Diwamoto/ownly/README.md

# ownly

ownly is 58 key qwerty custom split keyboard

[buildguide](https://github.com/Diwamoto/ownly/blob/master/docs/buildguide.md "buildguide")

This product released under the GNU GPL.
画像1

画像2

画像3

画像4
