Diwamoto/ownly/docs/stabilizer.md

# スタビライザの組み立て方
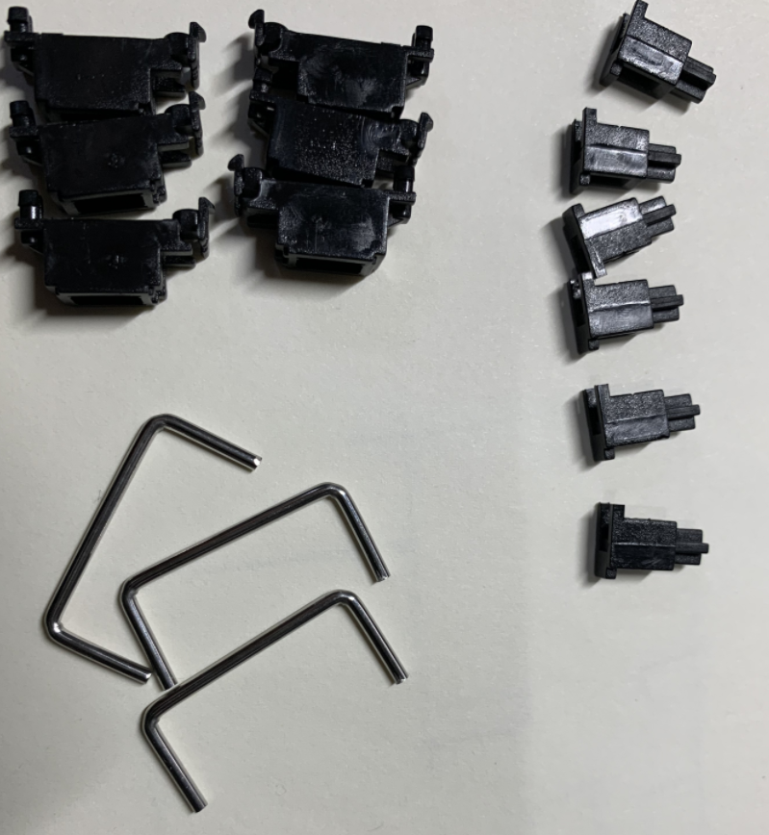
[picture p1: img/全体.png]


スタビライザは下記の三つの部品からなります（画像は3セット分）
・ワイヤ
・ハウジング
・ステム

## 1 向きを確認する
スタビライザのハウジングとステムには向きがあります。

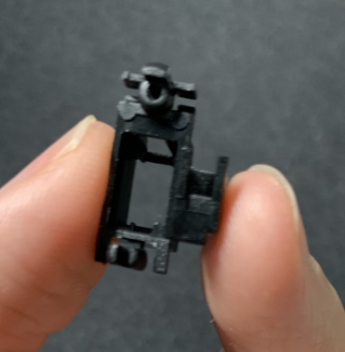
[picture p2: img/向き.png]


画像の向きに合わせて、差し込みます。

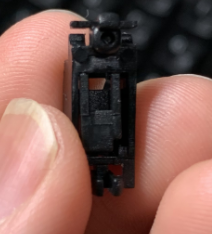
[picture p3: img/位置.png]


## 2 金具をひっかけます。
金具をハウジングにひっかけます。

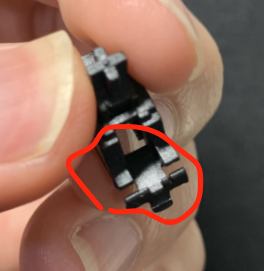
[picture p4: img/方向.png]


ひっかける方向は画像の赤くなっている部分です。
画像のように差し込んで、

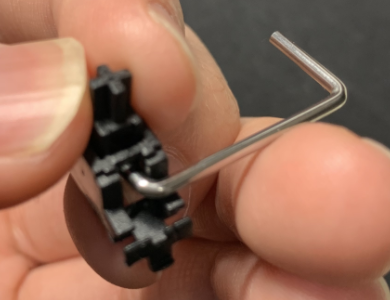
[picture p5: img/差し込む.png]


ひっかけます

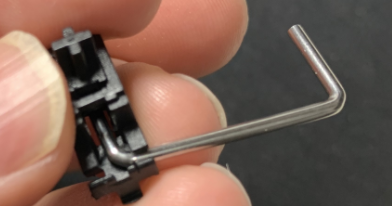
[picture p6: img/ひっかける.png]


反対側も同じようにして完成です。

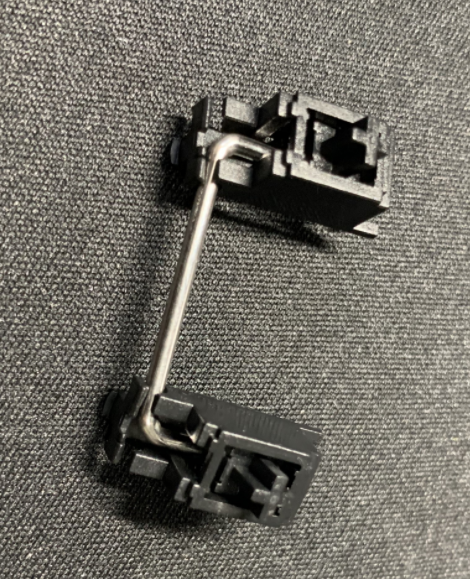
[picture p7: img/完成図.png]
