Diwamoto/ownly/img/IMG_6416.JPG

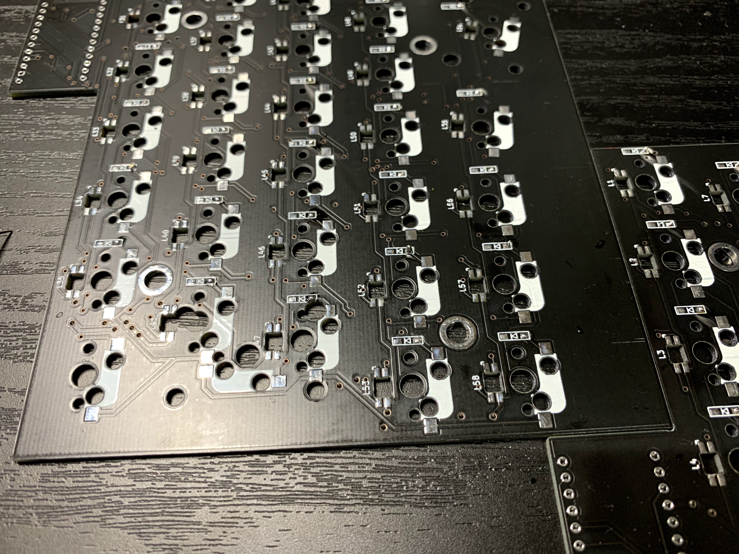
img/IMG_6416.JPG
