Diwamoto/ownly/img/IMG_6417.JPG

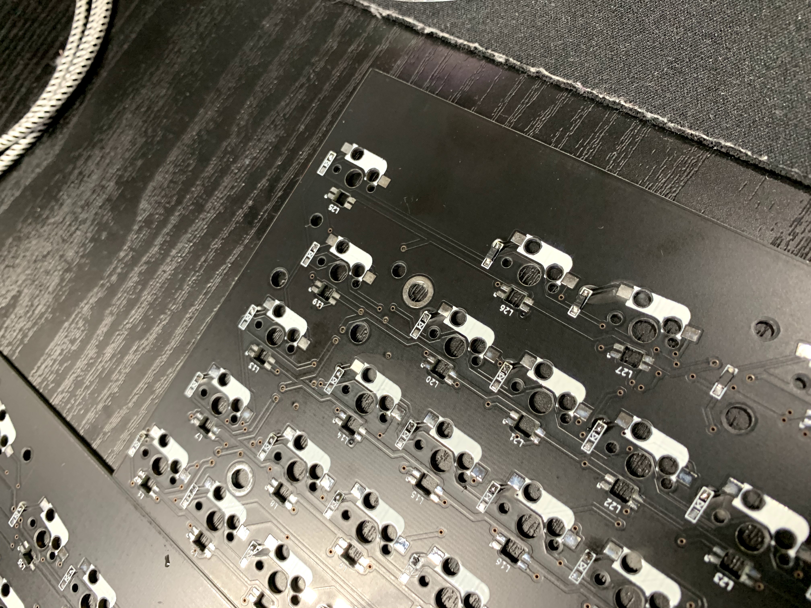
img/IMG_6417.JPG
