Diwamoto/ownly/img/IMG_6419.JPG

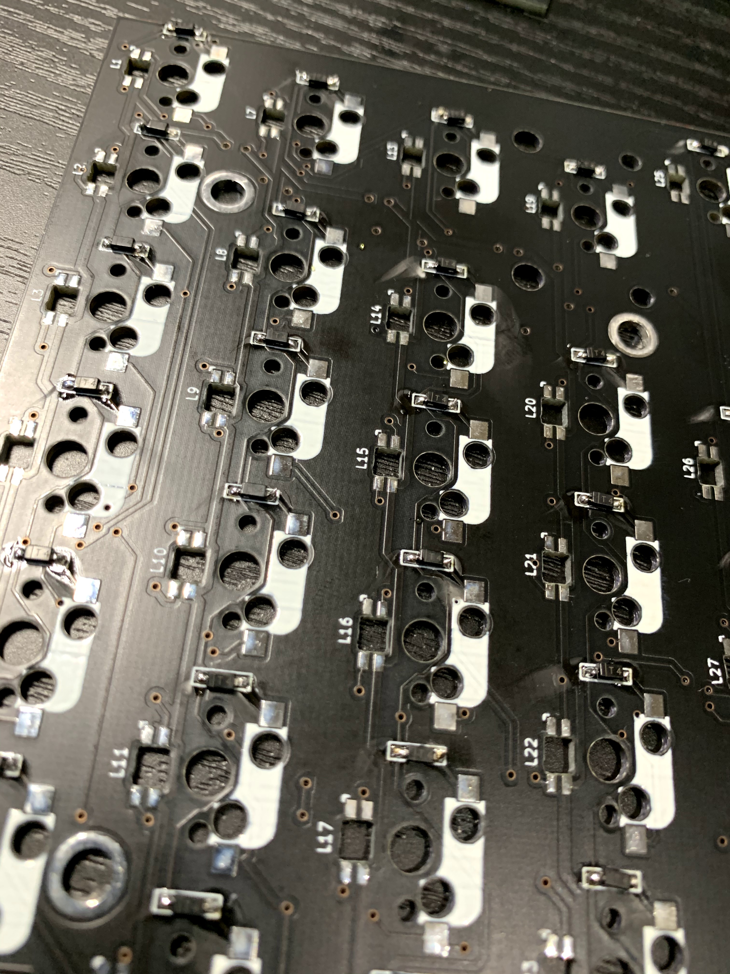
img/IMG_6419.JPG
