Diwamoto/ownly/img/IMG_6426.JPG

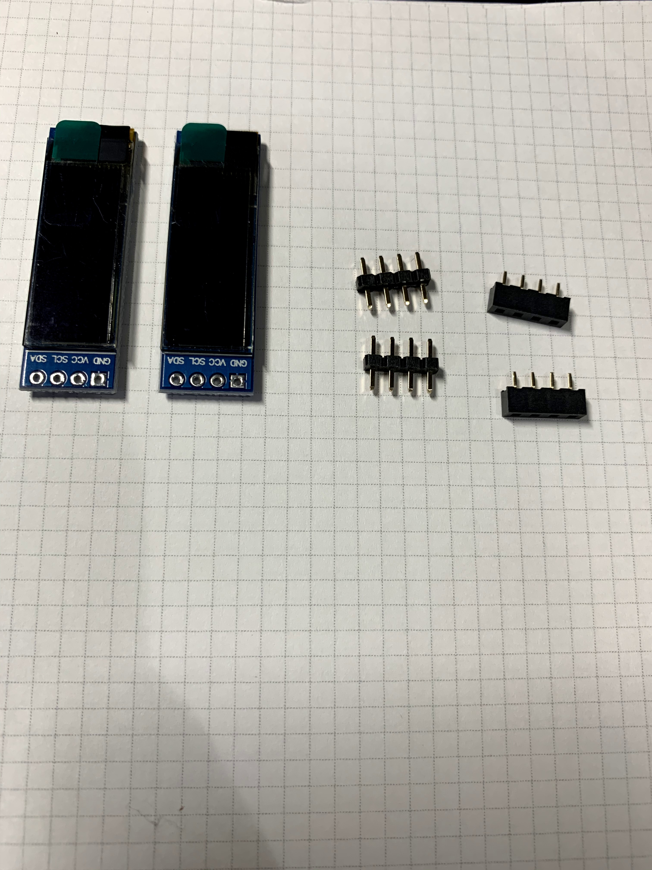
img/IMG_6426.JPG
