Diwamoto/ownly/img/IMG_6427.JPG

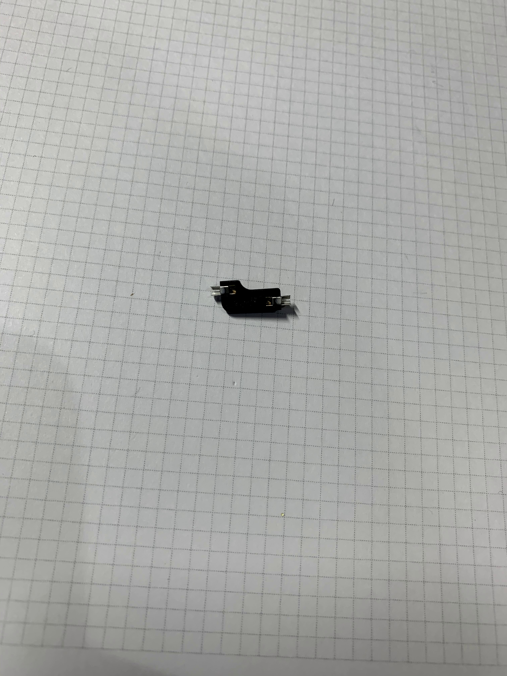
img/IMG_6427.JPG
