Diwamoto/ownly/img/IMG_6428.JPG

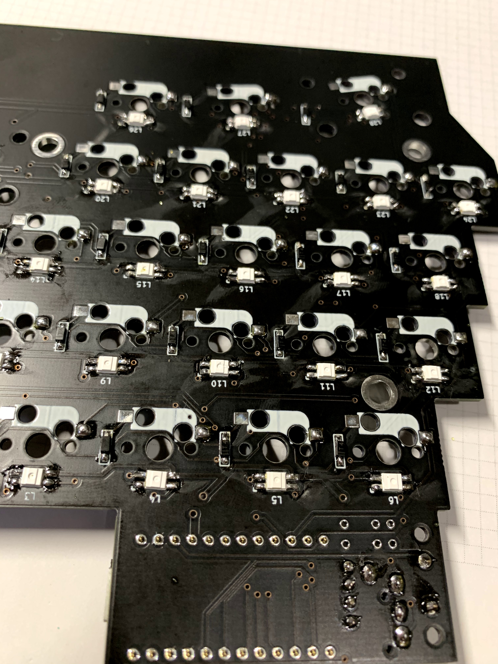
img/IMG_6428.JPG
