Diwamoto/ownly/img/IMG_6429.JPG

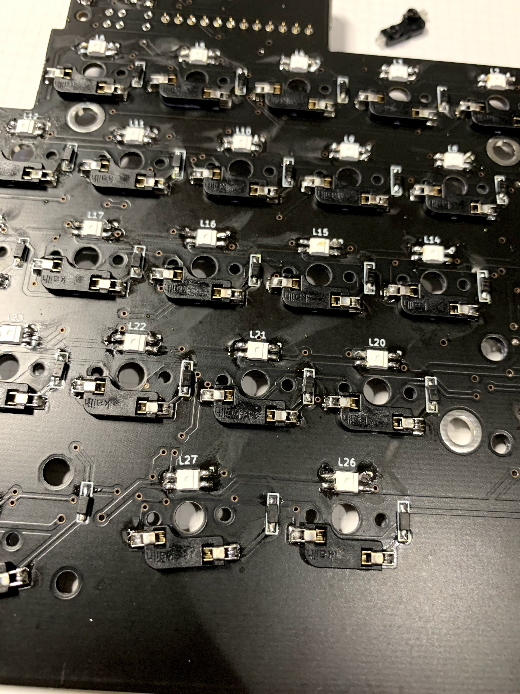
img/IMG_6429.JPG
