Diwamoto/ownly/img/oled.png

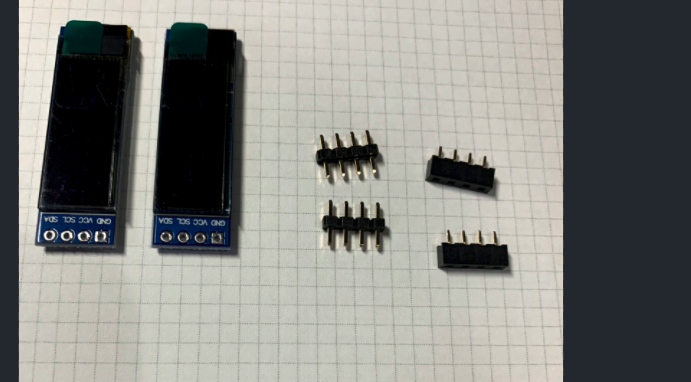
img/oled.png
