Diwamoto/ownly/img/スイッチ取り付け.png

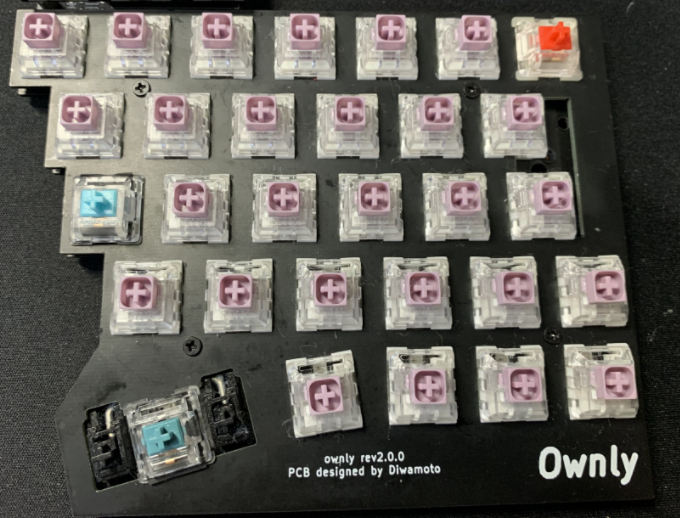
img/スイッチ取り付け.png
