Diwamoto/ownly/img/追加プレート取り付け.png

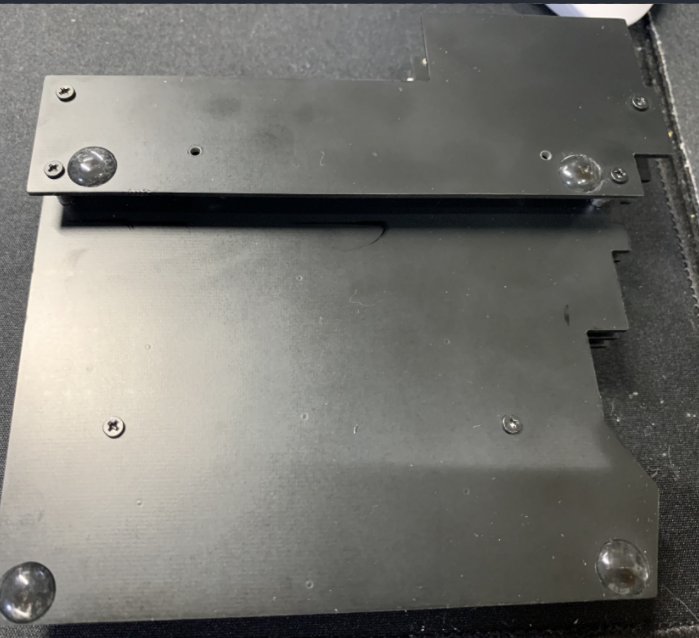
img/追加プレート取り付け.png
