Diwamoto/ownly/dxf/ownly-top-plate-Edge_Cuts.dxf

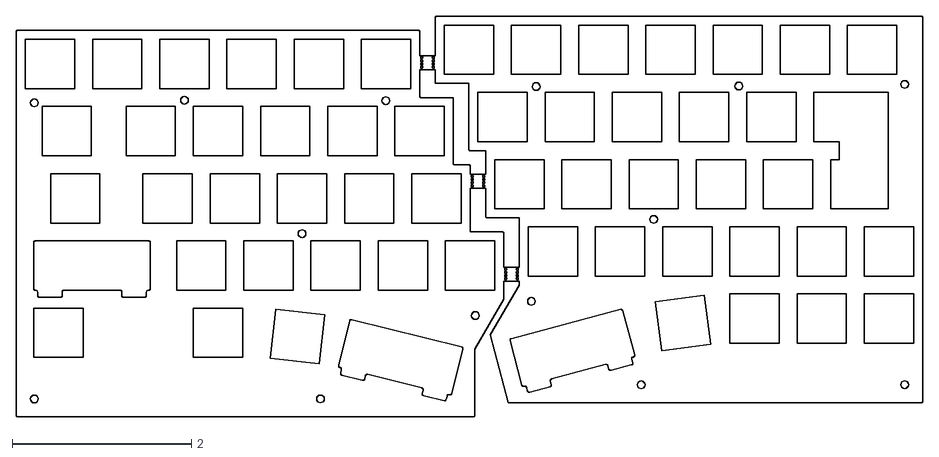
[picture p24: CAD file, 2021-02-08]
dxf/ownly-top-plate-Edge_Cuts.dxf
10.1 x 4.47
