Diwamoto/ownly/dxf/ownly-Edge_Cuts.dxf

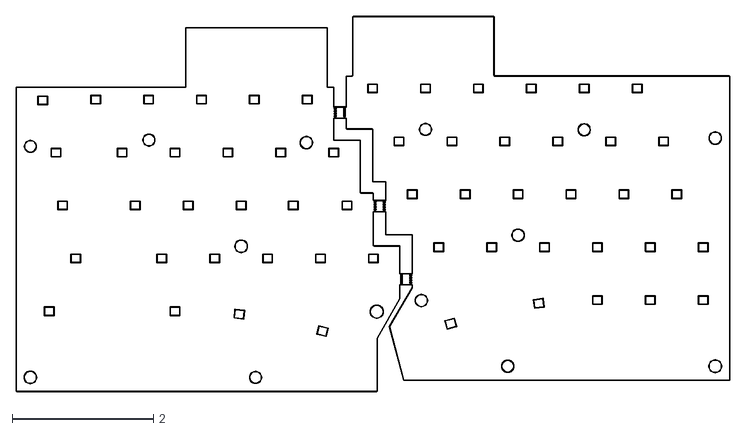
[picture p25: CAD file, 2020-08-29]
dxf/ownly-Edge_Cuts.dxf
10.1 x 5.32
