Diwamoto/ownly/PCB/ownly.pdf

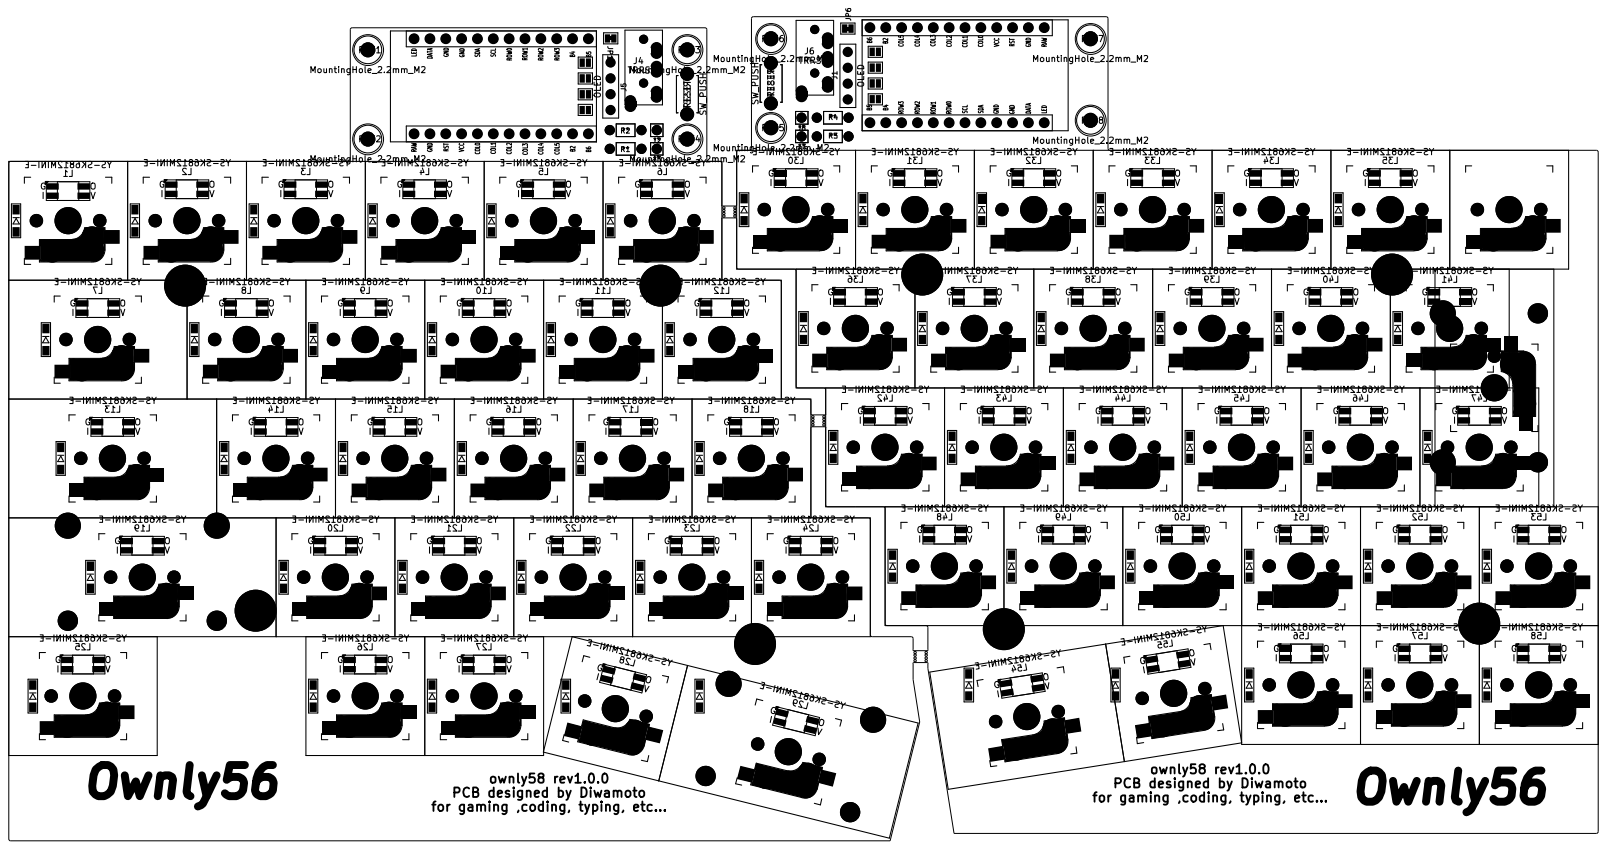
[picture p46: page 1]
