Diwamoto/ownly/PCB/ownly.kicad_pcb

## KiCad design PCB/ownly.kicad_pcb (2020-10-05)

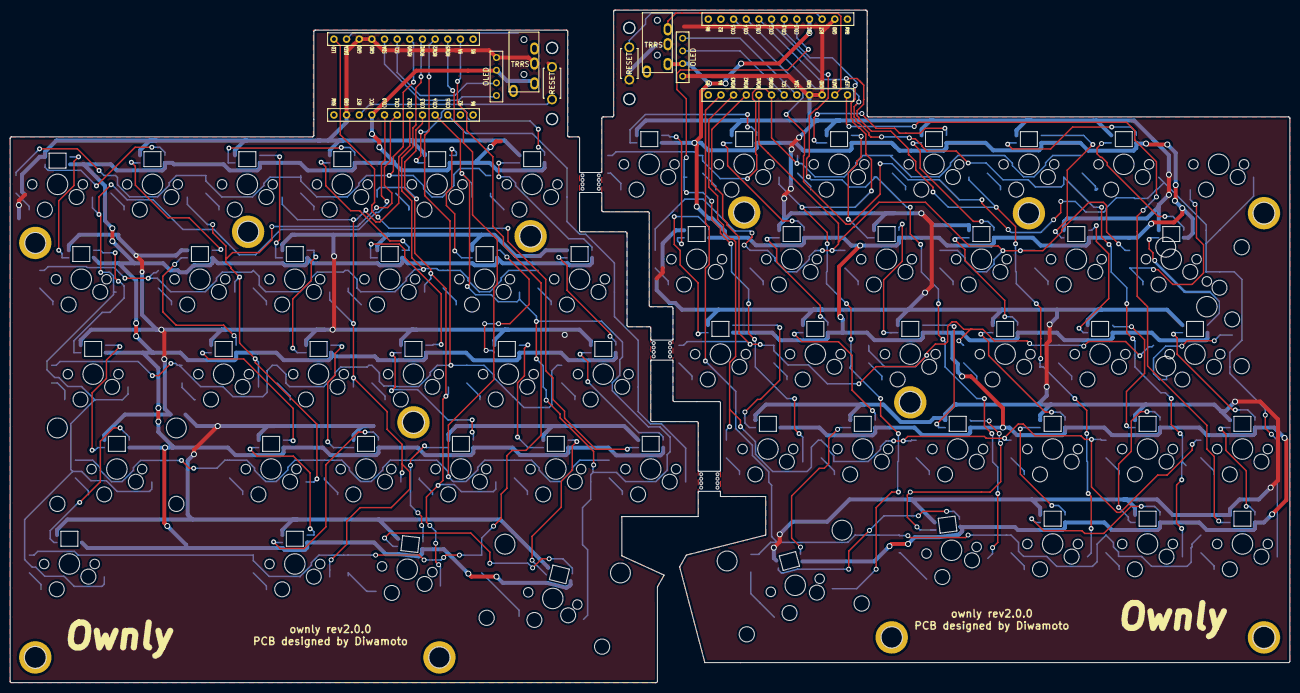
[picture p47: board ownly.kicad_pcb from above]

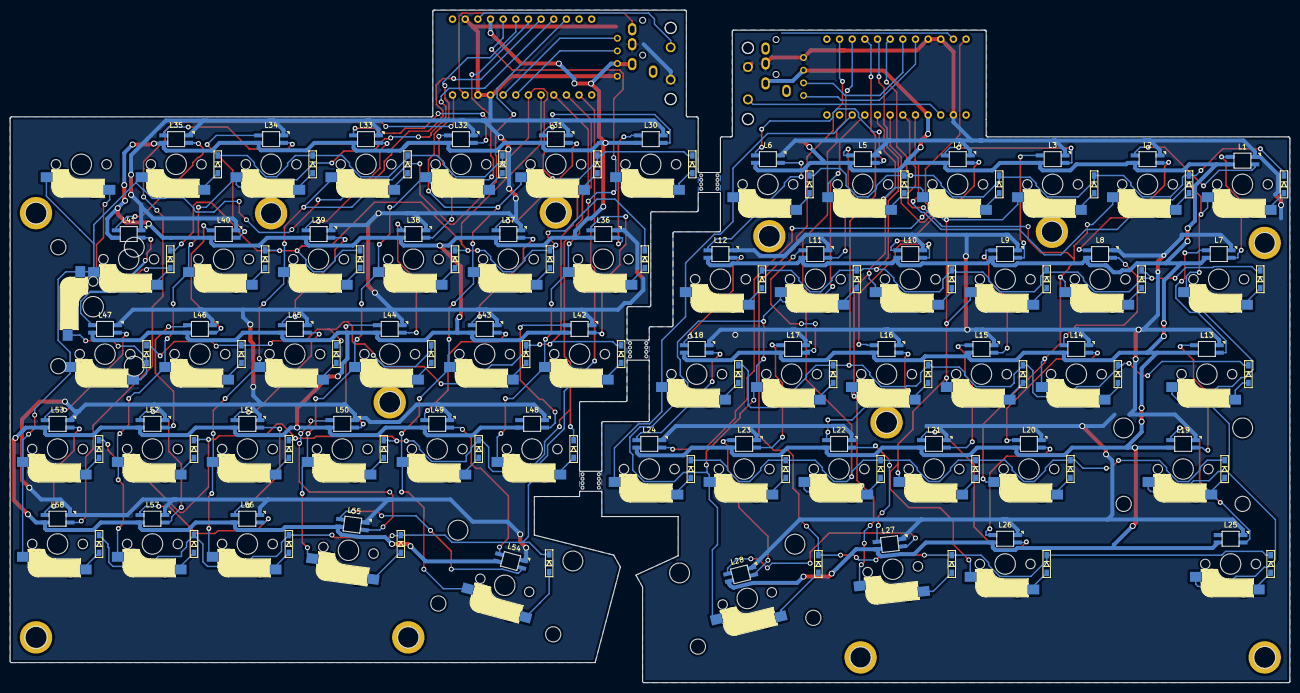
[picture p48: board ownly.kicad_pcb from below]

Board: 2 copper layers, 256.9 x 135.0 mm, 197 parts (57 on the bottom side), 146 nets.

Parts:
D1, D2, D3, D4, D5, D6, D7, D8, D9, D10, D11, D12, D13, D14, D15, D16, D17, D18, D19, D20, D21, D22, D23, D24, D25, D26, D27, D28, D30, D31, D32, D33, D34, D35, D36, D37, D38, D39, D40, D41, D42, D43, D44, D45, D46, D47, D48, D49, D50, D51, D52, D53, D54, D55, D56, D57, D58: D; D3_SMD
J1, J5: OLED; OLED_1side
J2, J4: MJ-4PP-9; MJ-4PP-9_1side
L1, L2, L3, L4, L5, L6, L7, L8, L9, L10, L11, L12, L13, L14, L15, L16, L17, L18, L19, L20, L21, L22, L23, L24, L25, L26, L27, L28, L30, L31, L32, L33, L34, L35, L36, L37, L38, L39, L40, L41, L42, L43, L44, L45, L46, L47, L48, L49, L50, L51, L52, L53, L54, L55, L56, L57, L58: YS-SK6812MINI-E
REF3, REF4, REF5, REF6: MountingHole_2.2mm_M2
RSW1, RSW2: SW_PUSH; ResetSW
Ref101: Val1; M2_HOLE
Ref102: Val2; M2_HOLE
Ref104, Ref104#2, Ref104#3, Ref104#4, Ref104#5: Val4; M2_HOLE
Ref107, Ref107#2, Ref107#3, Ref107#4: Val7; M2_HOLE
Ref108: Val8; M2_HOLE
SW1, SW2, SW3, SW4, SW5, SW6, SW8, SW9, SW10, SW11, SW12, SW14, SW15, SW16, SW17, SW18, SW20, SW21, SW22, SW23, SW24, SW27, SW30, SW31, SW32, SW33, SW34, SW35, SW36, SW37, SW38, SW39, SW40, SW41, SW41', SW42, SW43, SW44, SW45, SW46, SW47, SW48, SW49, SW50, SW51, SW52, SW53, SW55, SW56, SW57, SW58: SW_PUSH; CherryMX_Hotswap
SW7: SW_PUSH; CherryMX_Hotswap_1.5u
SW13: SW_PUSH; CherryMX_Hotswap_1.75u
SW19, SW54: SW_PUSH; CherryMX_Hotswap_2.25u
SW25, SW26: SW_PUSH; CherryMX_Hotswap_1.25u
SW28: SW_PUSH; CherryMX_Hotswap_2u
SW47': KEY_SWITCH; CherryMX_Hotswap_iso_enter
U1, U2: ProMicro; ProMicro_v2_1side

Connections:
GND: J1.4, J2.C, J4.C, J5.4, L1.3, L2.3, L3.3, L4.3, L5.3, L6.3, L7.3, L8.3, L9.3, L10.3, L11.3, L12.3, L13.3, L14.3, L15.3, L16.3, L17.3, L18.3, L19.3, L20.3, L21.3, L22.3, L23.3, L24.3, L25.3, L26.3, L27.3, L28.3, L30.3, L31.3, L32.3, L33.3, L34.3, L35.3, L36.3, L37.3, L38.3, L39.3, L40.3, L41.3, L42.3, L43.3, L44.3, L45.3, L46.3, L47.3, L48.3, L49.3, L50.3, L51.3, L52.3, L53.3, L54.3, L55.3, L56.3, L57.3, L58.3, RSW1.2, RSW2.2, U1.3, U1.4, U1.23, U2.3, U2.4, U2.23
LED1: L24.4, U1.1
LED2: L58.4, U2.1
unnamed: D1.2, SW1.2
unnamed: D2.2, SW2.2
unnamed: D3.2, SW3.2
unnamed: D4.2, SW4.2
unnamed: D5.2, SW5.2
unnamed: D6.2, SW6.2
unnamed: D7.2, SW7.2
unnamed: D8.2, SW8.2
unnamed: D9.2, SW9.2
unnamed: D10.2, SW10.2
unnamed: D11.2, SW11.2
unnamed: D12.2, SW12.2
unnamed: D13.2, SW13.2
unnamed: D14.2, SW14.2
unnamed: D15.2, SW15.2
unnamed: D16.2, SW16.2
unnamed: D17.2, SW17.2
unnamed: D18.2, SW18.2
unnamed: D19.2, SW19.2
unnamed: D20.2, SW20.2
unnamed: D21.2, SW21.2
unnamed: D22.2, SW22.2
unnamed: D23.2, SW23.2
unnamed: D24.2, SW24.2
unnamed: D25.2, SW25.2
unnamed: D26.2, SW26.2
unnamed: D27.2, SW27.2
unnamed: D28.2, SW28.2
unnamed: D30.2, SW30.2
unnamed: D31.2, SW31.2
unnamed: D32.2, SW32.2
unnamed: D33.2, SW33.2
unnamed: D34.2, SW34.2
unnamed: D35.2, SW35.2
unnamed: D36.2, SW36.2
unnamed: D37.2, SW37.2
unnamed: D38.2, SW38.2
unnamed: D39.2, SW39.2
unnamed: D40.2, SW40.2
unnamed: D41.2, SW41.2, SW41'.2
unnamed: D42.2, SW42.2
unnamed: D43.2, SW43.2
unnamed: D44.2, SW44.2
unnamed: D45.2, SW45.2
unnamed: D46.2, SW46.2
unnamed: D47.2, SW47.2, SW47'.2
unnamed: D48.2, SW48.2
unnamed: D49.2, SW49.2
unnamed: D50.2, SW50.2
unnamed: D51.2, SW51.2
unnamed: D52.2, SW52.2
unnamed: D53.2, SW53.2
unnamed: D54.2, SW54.2
unnamed: D55.2, SW55.2
unnamed: D56.2, SW56.2
unnamed: D57.2, SW57.2
unnamed: D58.2, SW58.2
unnamed: L1.2, L7.4
unnamed: L1.4, L2.2
unnamed: L2.4, L8.2
unnamed: L3.2, L9.4
unnamed: L3.4, L4.2
unnamed: L5.4, L6.2
unnamed: L4.4, L10.2
unnamed: L10.4, L16.2
unnamed: L11.2, L17.4
unnamed: L5.2, L11.4
unnamed: L6.4, L12.2
unnamed: L12.4, L18.2
unnamed: L13.2, L19.4
unnamed: L7.2, L13.4
unnamed: L8.4, L14.2
unnamed: L14.4, L20.2
unnamed: L15.2, L21.4
unnamed: L9.2, L15.4
unnamed: L16.4, L22.2
unnamed: L17.2, L23.4
unnamed: L18.4, L24.2
unnamed: L19.2, L25.4
unnamed: L20.4, L26.2
unnamed: L21.2, L26.4
unnamed: L22.4, L27.2
unnamed: L23.2, L28.4
unnamed: L27.4, L28.2
unnamed: L30.2, L36.4
unnamed: L30.4, L31.2
unnamed: L31.4, L37.2
unnamed: L32.2, L38.4
unnamed: L32.4, L33.2
unnamed: L33.4, L39.2
unnamed: L34.2, L40.4
unnamed: L34.4, L35.2
unnamed: L35.4, L41.2
unnamed: L36.2, L42.4
unnamed: L37.4, L43.2
unnamed: L38.2, L44.4
unnamed: L39.4, L45.2
unnamed: L40.2, L46.4
unnamed: L41.4, L47.2
unnamed: L42.2, L48.4
unnamed: L43.4, L49.2
unnamed: L44.2, L50.4
unnamed: L45.4, L51.2
unnamed: L46.2, L52.4
unnamed: L47.4, L53.2
unnamed: L49.4, L54.2
unnamed: L50.2, L55.4
unnamed: L51.4, L56.2
unnamed: L52.2, L57.4
unnamed: L53.4, L58.2
unnamed: L54.4, L55.2
unnamed: L56.4, L57.2
SCL1: J5.2, U1.6
SCL2: J1.2, U2.6
SDA1: J5.1, U1.5
SDA2: J1.1, U2.5
VCC: J1.3, J2.D, J4.D, J5.3, L1.1, L2.1, L3.1, L4.1, L5.1, L6.1, L7.1, L8.1, L9.1, L10.1, L11.1, L12.1, L13.1, L14.1, L15.1, L16.1, L17.1, L18.1, L19.1, L20.1, L21.1, L22.1, L23.1, L24.1, L25.1, L26.1, L27.1, L28.1, L30.1, L31.1, L32.1, L33.1, L34.1, L35.1, L36.1, L37.1, L38.1, L39.1, L40.1, L41.1, L42.1, L43.1, L44.1, L45.1, L46.1, L47.1, L48.1, L49.1, L50.1, L51.1, L52.1, L53.1, L54.1, L55.1, L56.1, L57.1, L58.1, U1.21, U2.21
col00: SW30.1, SW36.1, SW42.1, SW48.1, U2.20
col0: SW1.1, SW7.1, SW13.1, SW19.1, SW25.1, U1.20
col01: SW31.1, SW37.1, SW43.1, SW49.1, SW54.1, U2.19
col1: SW2.1, SW8.1, SW14.1, SW20.1, U1.19
col02: SW32.1, SW38.1, SW44.1, SW50.1, SW55.1, U2.18
col2: SW3.1, SW9.1, SW15.1, SW21.1, SW26.1, U1.18
col03: SW33.1, SW39.1, SW45.1, SW51.1, SW56.1, U2.17
col3: SW4.1, SW10.1, SW16.1, SW22.1, SW27.1, U1.17
col04: SW34.1, SW40.1, SW46.1, SW52.1, SW57.1, U2.16
col4: SW5.1, SW11.1, SW17.1, SW23.1, SW28.1, U1.16
col05: SW35.1, SW41.1, SW41'.1, SW47.1, SW47'.1, SW53.1, SW58.1, U2.15
col5: SW6.1, SW12.1, SW18.1, SW24.1, U1.15
data1: J4.B, U1.2
data2: J2.B, U2.2
reset1: RSW1.1, U1.22
reset2: RSW2.1, U2.22
row00: D30.1, D31.1, D32.1, D33.1, D34.1, D35.1, U2.7
row0: D1.1, D2.1, D3.1, D4.1, D5.1, D6.1, U1.7
row01: D36.1, D37.1, D38.1, D39.1, D40.1, D41.1, U2.8
row1: D7.1, D8.1, D9.1, D10.1, D11.1, D12.1, U1.8
row02: D42.1, D43.1, D44.1, D45.1, D46.1, D47.1, U2.9
row2: D13.1, D14.1, D15.1, D16.1, D17.1, D18.1, U1.9
row03: D48.1, D49.1, D50.1, D51.1, D52.1, D53.1, U2.10
row3: D19.1, D20.1, D21.1, D22.1, D23.1, D24.1, U1.10
row04: D54.1, D55.1, D56.1, D57.1, D58.1, U2.11
row4: D25.1, D26.1, D27.1, D28.1, U1.11
