Diwamoto/ownly/(commit log)

2020-08-29 dxfファイルとvia用jsoファイルを追加
    [ownly-Edge_Cuts.dxf, ownly-top-plate-Edge_Cuts.dxf]
2020-10-05 製品版をコミット
    [ownly-bottom-plate.kicad_pcb, ownly-plate.kicad_pcb, ownly-top-plate.kicad_pcb, ownly.kicad_pcb, ownly.sch]
2020-11-04 ビルドガイドを更新
2020-11-04 画像差し替え
2020-12-26 写真をコミット
2020-12-26 ビルドガイド更新
2020-12-27 ビルドガイドの画像のリンク切れを修正
2020-12-27 リンク切れを調整
2020-12-28 via用のjsonとbmp用のjson公開
2021-01-07 oledのリンクを修正
2021-01-24 画像をコミット
2021-01-24 スタビライザの組み立て方を追加
2021-01-24 説明書を整形
2021-01-24 ビルドガイド更新 rgb_matrixを追加
2021-01-26 ビルドガイド更新ん
2021-02-08 dxfを更新
    [ownly-top-plate-Edge_Cuts.dxf]
2021-02-22 デフォルトのファームウェアを追加
2021-02-23 via用のjsonを更新
2021-03-02 配布ファームをRemap対応ファームに変更
2021-03-02 remapに対応している旨を追記
