Diwamoto/ownly/img/IMG_6418.JPG

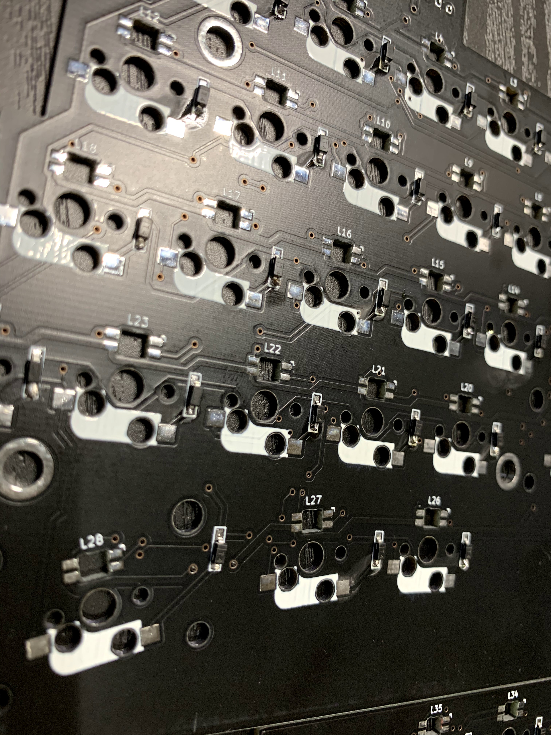
img/IMG_6418.JPG
