Diwamoto/ownly/img/IMG_6420.JPG

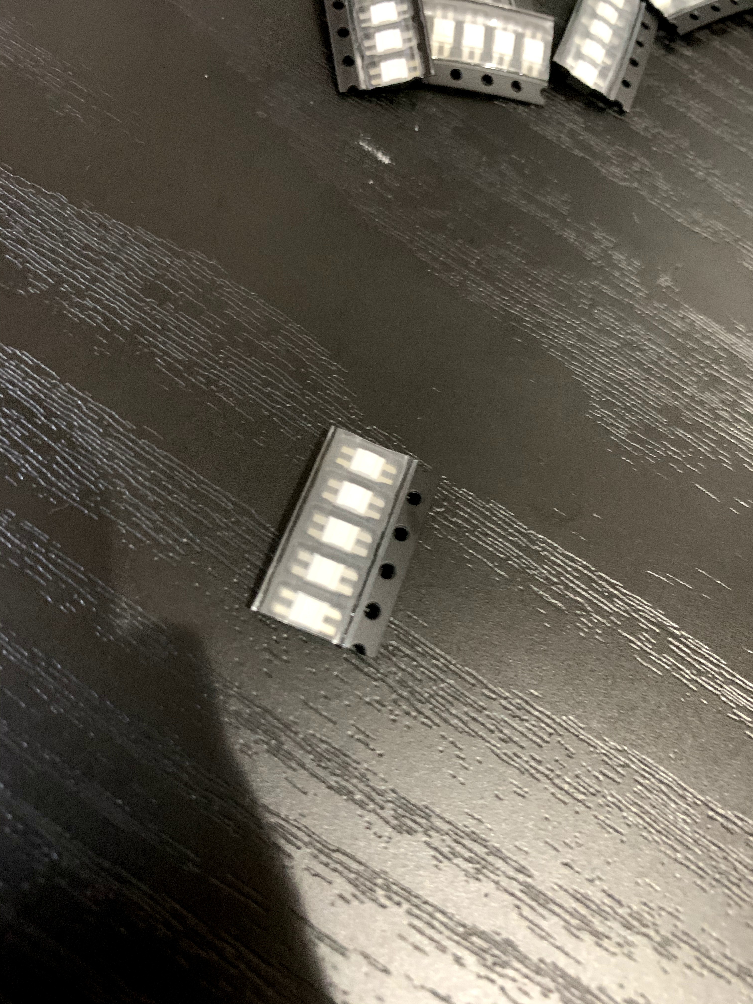
img/IMG_6420.JPG
