Diwamoto/ownly/img/IMG_6421.JPG

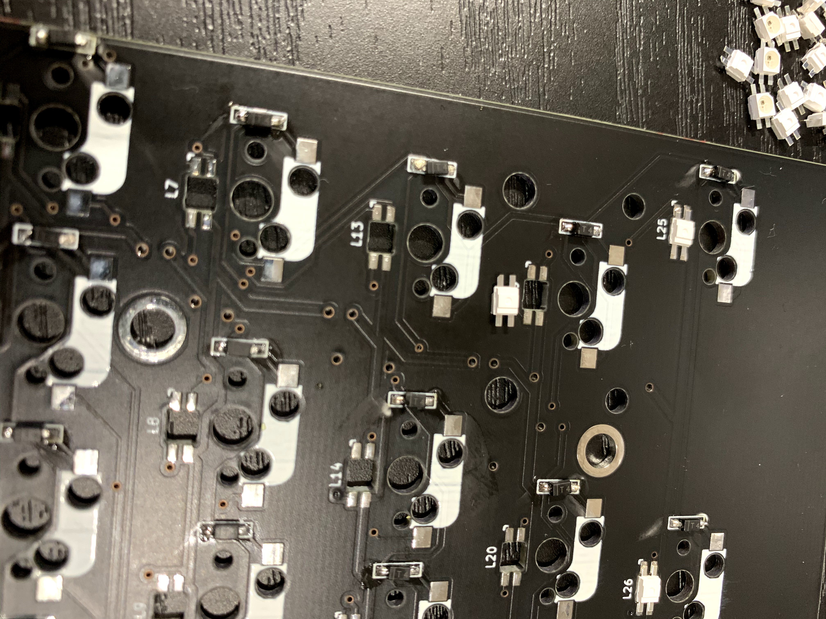
img/IMG_6421.JPG
