Diwamoto/ownly/img/IMG_6422.JPG

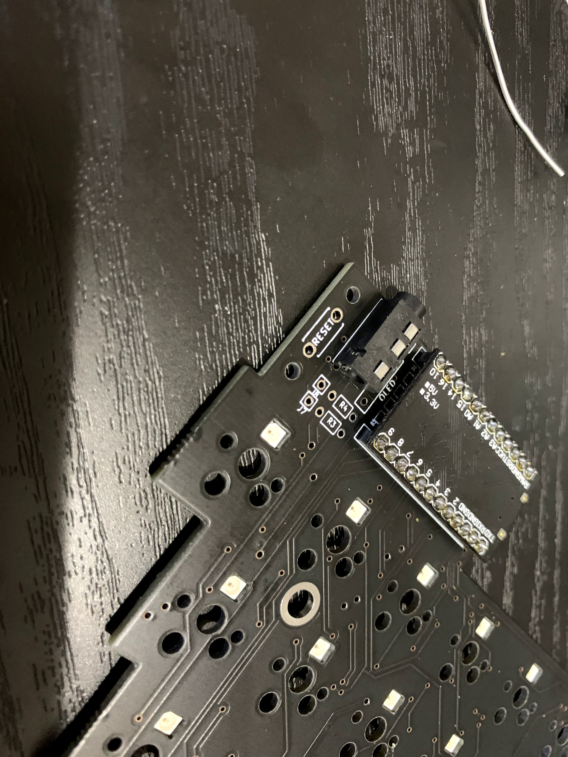
img/IMG_6422.JPG
