Diwamoto/ownly/img/IMG_6424.JPG

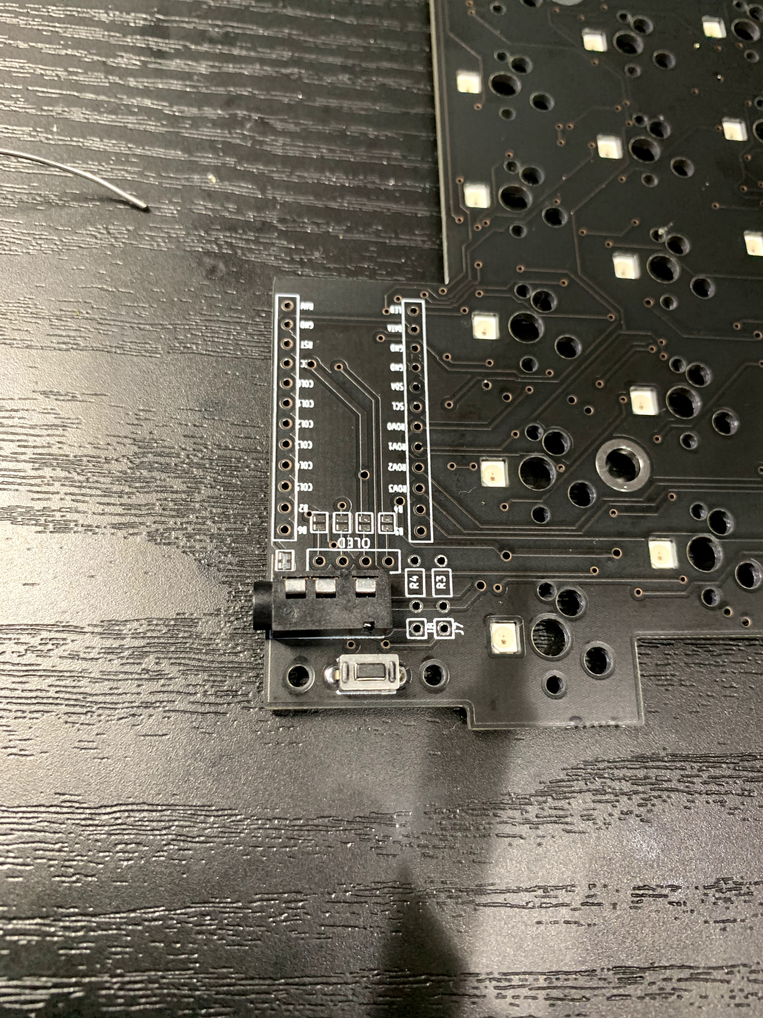
img/IMG_6424.JPG
