Diwamoto/ownly/img/IMG_6433.JPG

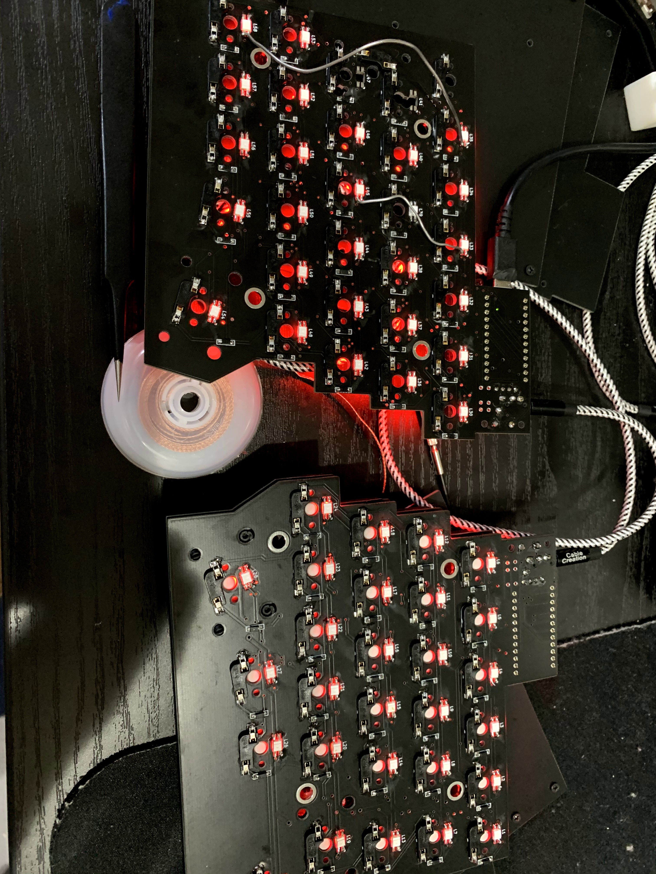
img/IMG_6433.JPG
